kjaworska94/Arduino/README.md

# Praca-Inzynierska
Stacja pogodowa - Arduino
Celem niniejszej pracy było zaprojektowanie mini stacji meteorologicznej. Stacja dokonywała takich pomiarów jak: temperatura, wilgotność, ciśnienie, nasłonecznienie oraz opady deszczu. Projekt zrealizowany został za pomocą dwóch platform Arduino, do których podłączony został odbiornik oraz nadajnik, dzięki czemu możliwy był odczyt pomiarów z zewnątrz oraz przesyłanie danych do miejsca, w którym aktualnie znajdował się odbiornik.
